sburgic/power_supply/0-35V 0-3A/doc/004.jpg

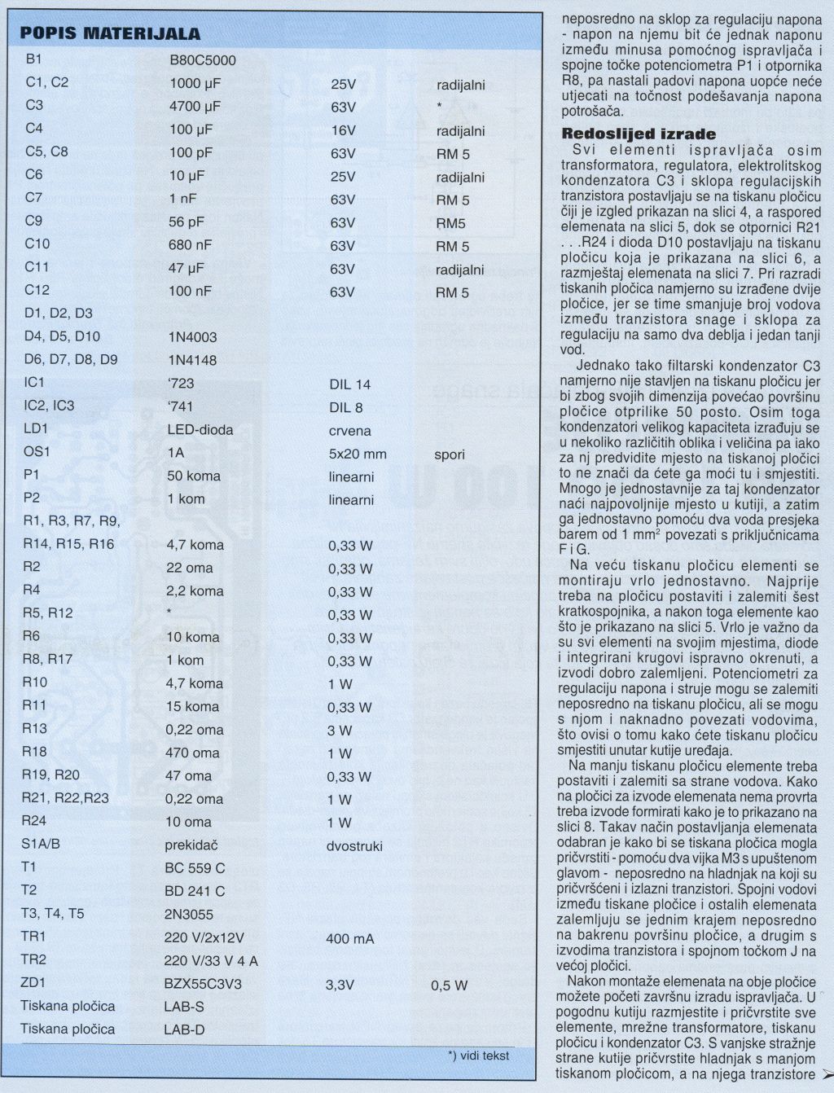
0-35V 0-3A/doc/004.jpg
