sburgic/power_supply/0-35V 0-3A/doc/001.jpg

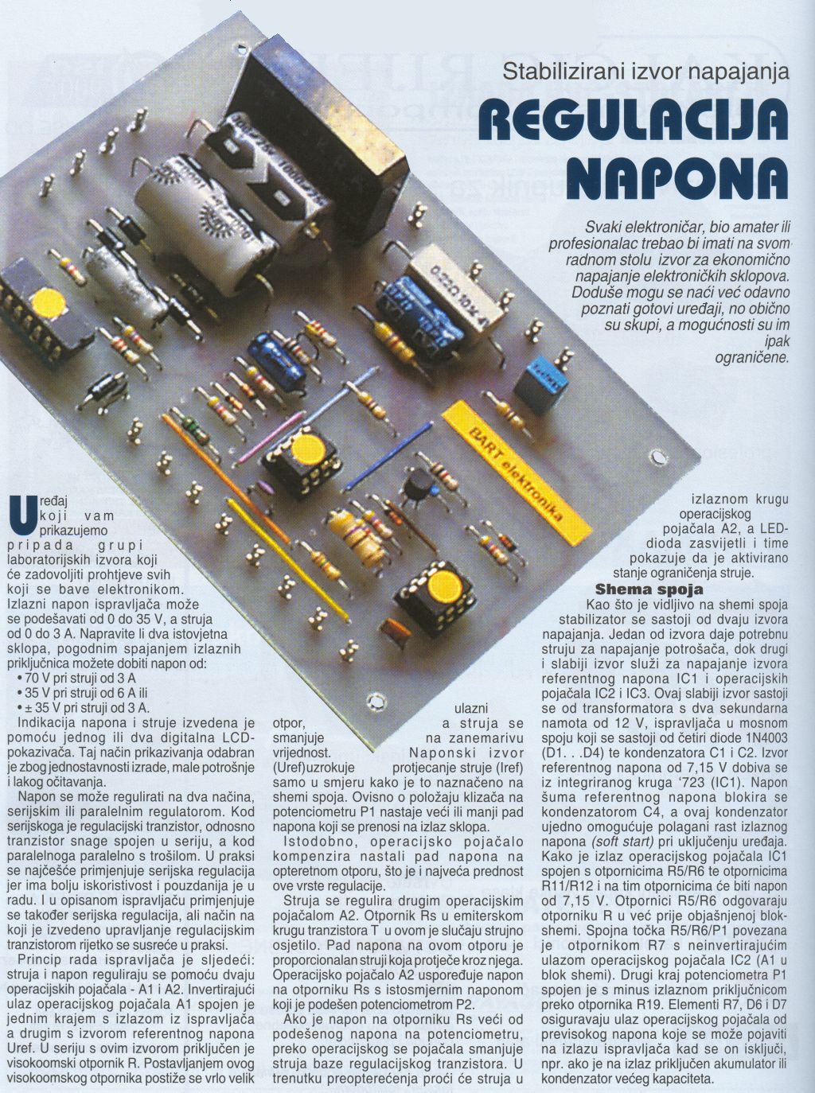
0-35V 0-3A/doc/001.jpg
