sburgic/power_supply/0-35V 0-3A/doc/005.jpg

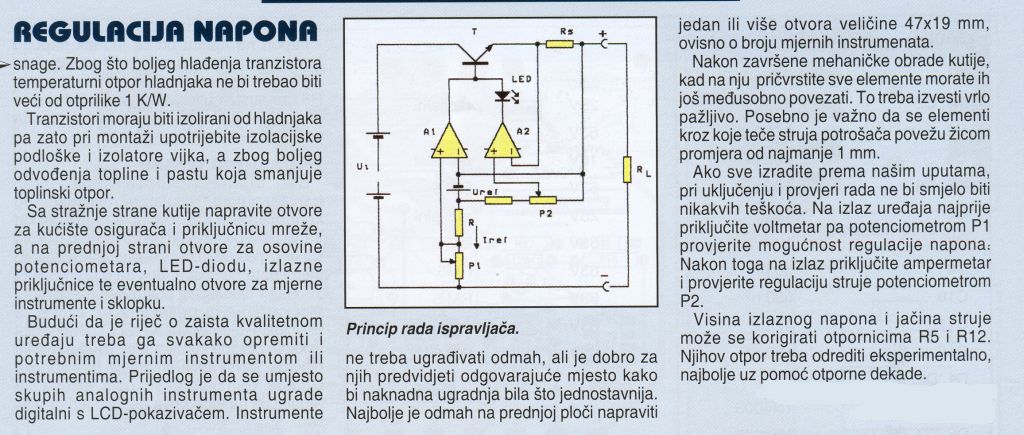
0-35V 0-3A/doc/005.jpg
