sburgic/power_supply/0-35V 0-3A/doc/old_eagle_schematics_35v_3a.pdf

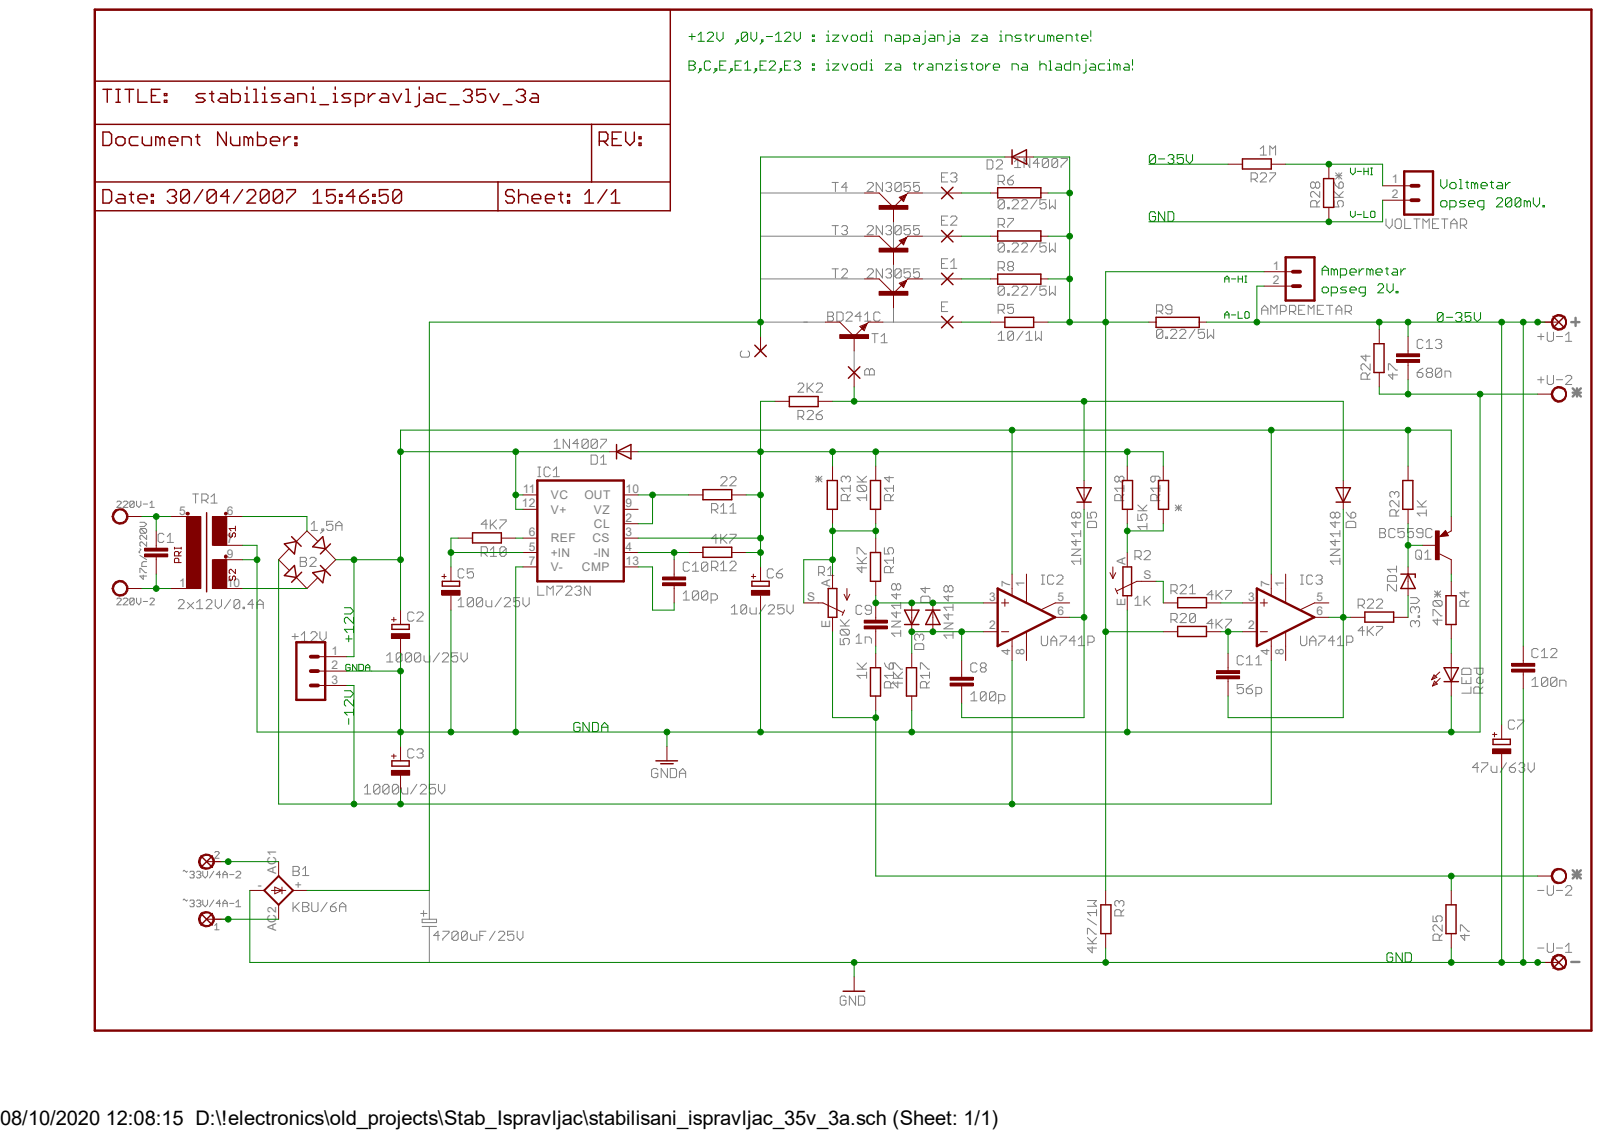
[picture p6: page 1]
OUT; REF 6 +IN 5 V- 7; CMP

08/10/2020 12:08:15 D:\!electronics\old_projects\Stab_Ispravljac\stabilisani_ispravljac_35v_3a.sch (Sheet: 1/1)
