sburgic/power_supply/0-35V 0-3A/kicad/power_supply_35V_3A.kicad_pcb

## KiCad design 0-35V 0-3A/kicad/power_supply_35V_3A.kicad_pcb (2020-10-16)

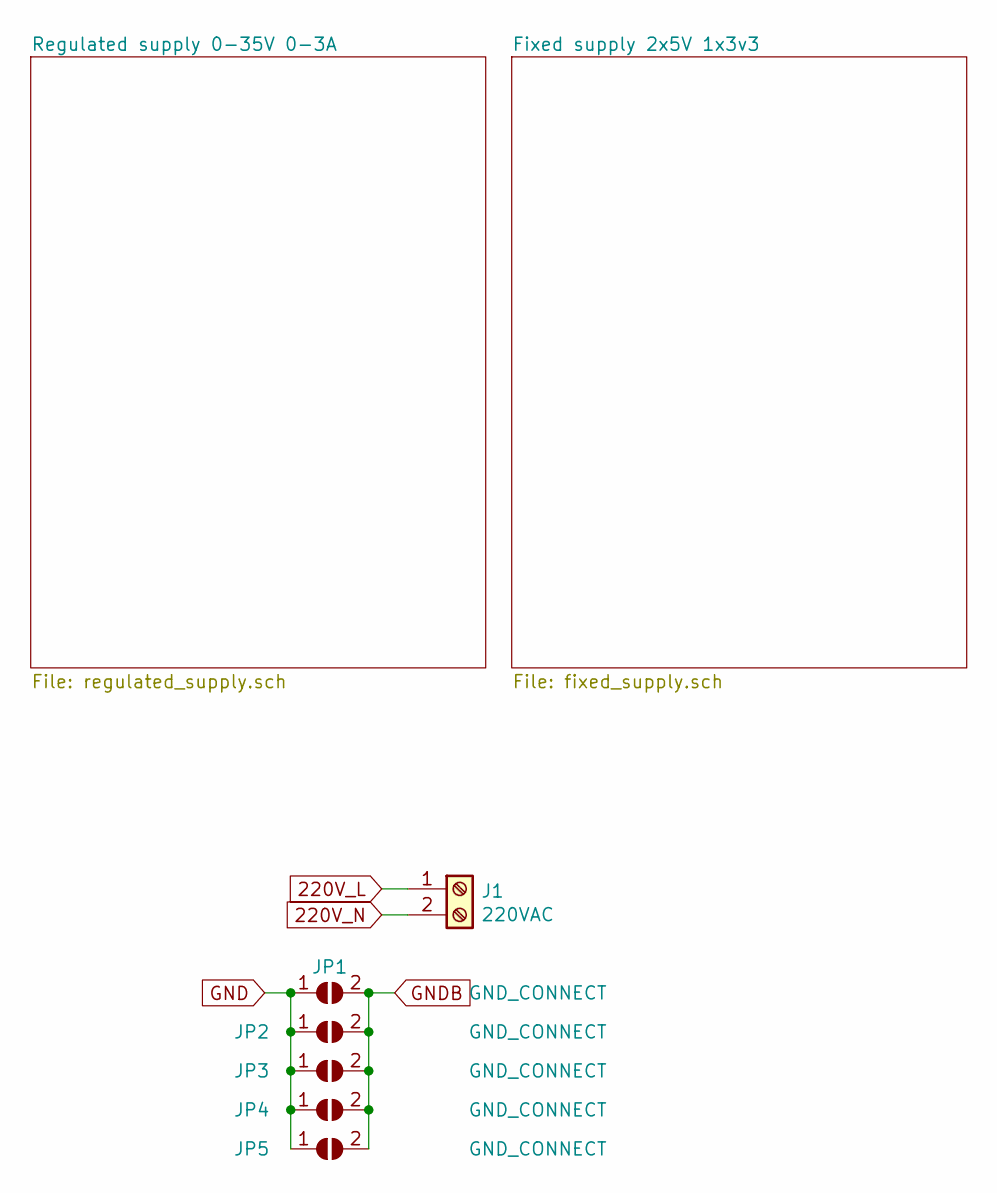
[picture p7: schematic power_supply_35V_3A.sch]

Parts:
J1: 220VAC; TerminalBlock_RND_205-00001_1x02_P5.00mm_Horizontal
JP1, JP2, JP3, JP4, JP5: GND_CONNECT; SolderJumper-2_P1.3mm_Open_Pad1.0x1.5mm

Connections:
220V_L: J1.1; also elsewhere on the board
220V_N: J1.2; also elsewhere on the board
GND: JP1.1 (A), JP2.1 (A), JP3.1 (A), JP4.1 (A), JP5.1 (A); also elsewhere on the board
GNDB: JP1.2 (B), JP2.2 (B), JP3.2 (B), JP4.2 (B), JP5.2 (B); also elsewhere on the board

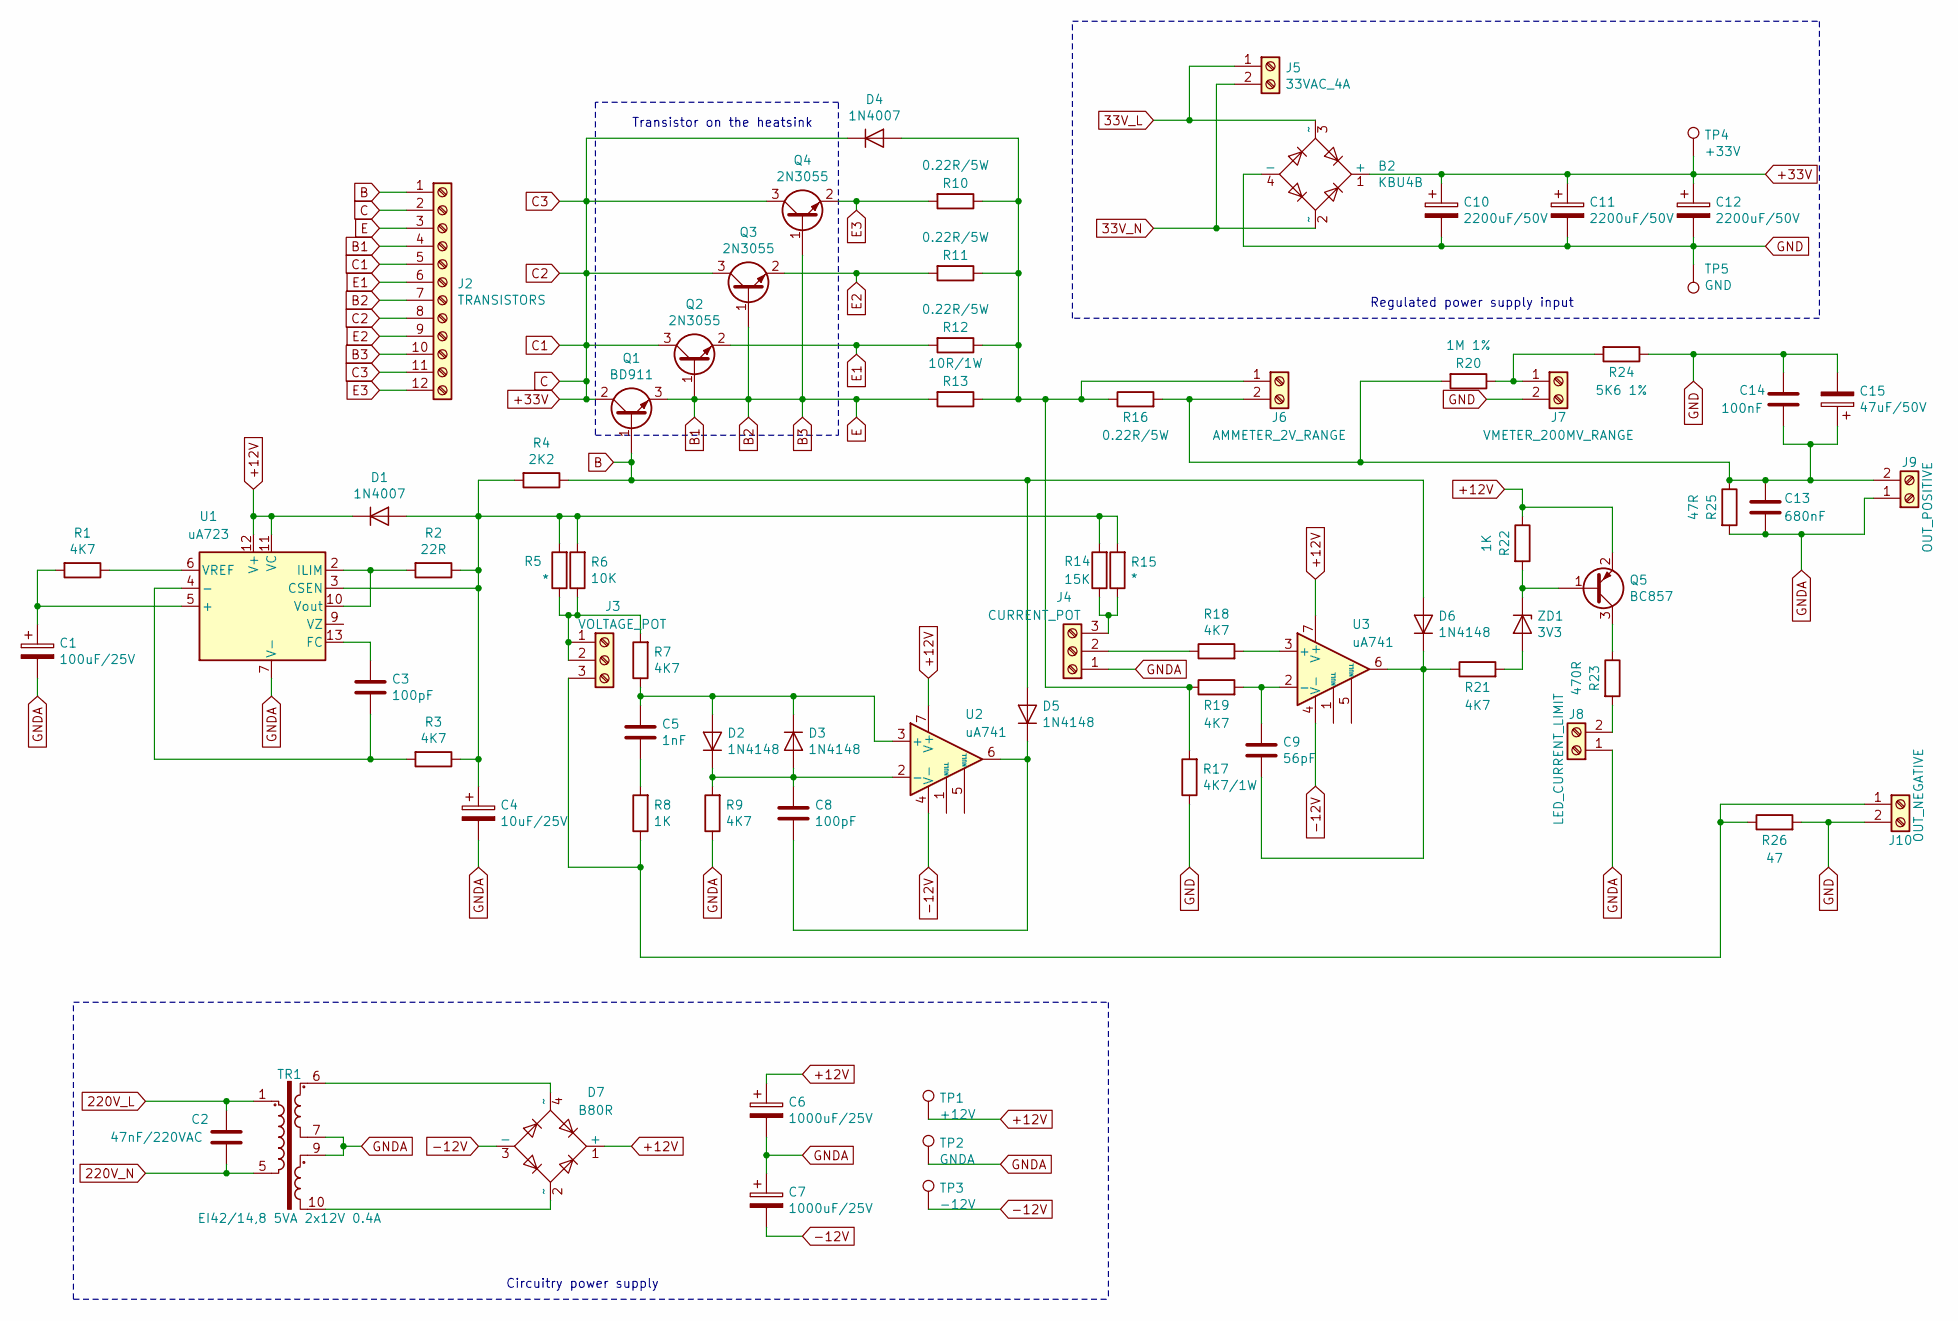
[picture p8: schematic regulated_supply.sch]

Parts:
B2: KBU4B; Diode_Bridge_Vishay_KBU
C1: 100uF/25V; CP_Radial_D6.3mm_P2.50mm
C2: 47nF/220VAC; C_Rect_L16.5mm_W7.3mm_P15.00mm_MKT
C3, C8: 100pF; C_0805_2012Metric_Pad1.15x1.40mm_HandSolder
C4: 10uF/25V; CP_Radial_D6.3mm_P2.50mm
C5: 1nF; R_0603_1608Metric_Pad1.05x0.95mm_HandSolder
C6, C7: 1000uF/25V; CP_Radial_D12.5mm_P5.00mm
C9: 56pF; C_0805_2012Metric_Pad1.15x1.40mm_HandSolder
C10, C11, C12: 2200uF/50V; CP_Radial_D16.0mm_P7.50mm
C13: 680nF; C_0805_2012Metric_Pad1.15x1.40mm_HandSolder
C14: 100nF; R_0603_1608Metric_Pad1.05x0.95mm_HandSolder
C15: 47uF/50V; CP_Radial_D6.3mm_P2.50mm
D1, D4: 1N4007; D_DO-41_SOD81_P10.16mm_Horizontal
D2, D3, D5, D6: 1N4148; D_DO-35_SOD27_P7.62mm_Horizontal
D7: B80R; Diode_Bridge_Round_D9.0mm
J2: TRANSISTORS; TerminalBlock_RND_205-00055_1x12_P5.00mm_Horizontal
J3: VOLTAGE_POT; TerminalBlock_TE_282834-3_1x03_P2.54mm_Horizontal
J4: CURRENT_POT; TerminalBlock_TE_282834-3_1x03_P2.54mm_Horizontal
J5: 33VAC_4A; TerminalBlock_bornier-2_P5.08mm
J6: AMMETER_2V_RANGE; TerminalBlock_TE_282834-2_1x02_P2.54mm_Horizontal
J7: VMETER_200MV_RANGE; TerminalBlock_TE_282834-2_1x02_P2.54mm_Horizontal
J8: LED_CURRENT_LIMIT; TerminalBlock_TE_282834-2_1x02_P2.54mm_Horizontal
J9: OUT_POSITIVE; TerminalBlock_RND_205-00001_1x02_P5.00mm_Horizontal
J10: OUT_NEGATIVE; TerminalBlock_RND_205-00001_1x02_P5.00mm_Horizontal
Q1: BD911; TO-220-3_Vertical
Q2, Q3, Q4: 2N3055; TO-3
Q5: BC857; SOT-23
R1, R3, R7, R9, R18, R19, R21: 4K7; R_0805_2012Metric_Pad1.15x1.40mm_HandSolder
R2: 22R; R_0805_2012Metric_Pad1.15x1.40mm_HandSolder
R4: 2K2; R_0805_2012Metric_Pad1.15x1.40mm_HandSolder
R5, R15: *; R_0805_2012Metric_Pad1.15x1.40mm_HandSolder
R6: 10K; R_0805_2012Metric_Pad1.15x1.40mm_HandSolder
R8, R22: 1K; R_0805_2012Metric_Pad1.15x1.40mm_HandSolder
R10, R11, R12, R16: 0.22R/5W; R_Axial_Power_L20.0mm_W6.4mm_P5.08mm_Vertical
R13: 10R/1W; R_Bare_Metal_Element_L12.4mm_W4.8mm_P11.40mm
R14: 15K; R_0805_2012Metric_Pad1.15x1.40mm_HandSolder
R17: 4K7/1W; R_Bare_Metal_Element_L12.4mm_W4.8mm_P11.40mm
R20: 1M 1%; R_0805_2012Metric_Pad1.15x1.40mm_HandSolder
R23: 470R; R_0805_2012Metric_Pad1.15x1.40mm_HandSolder
R24: 5K6 1%; R_0805_2012Metric_Pad1.15x1.40mm_HandSolder
R25: 47R; R_0805_2012Metric_Pad1.15x1.40mm_HandSolder
R26: 47; R_0805_2012Metric_Pad1.15x1.40mm_HandSolder
TP1: +12V; TestPoint_Pad_D3.0mm
TP2: GNDA; TestPoint_Pad_D3.0mm
TP3: -12V; TestPoint_Pad_D3.0mm
TP4: +33V; TestPoint_Pad_D3.0mm
TP5: GND; TestPoint_Pad_D3.0mm
TR1: EI42/14,8 5VA 2x12V 0.4A; Transformer_Breve_TEZ-38x45
U1: uA723; DIP-14_W7.62mm
U2, U3: uA741; DIP-8_W7.62mm
ZD1: 3V3; D_DO-35_SOD27_P7.62mm_Horizontal

Connections:
33V_L: B2.3 (~~), J5.1
33V_N: B2.2 (~~), J5.2
220V_L: C2.1, TR1.1; also elsewhere on the board
220V_N: C2.2, TR1.5; also elsewhere on the board
+12V: C6.1, D1.1 (K), D7.1 (+), Q5.2 (E), R22.1, TP1.1, U1.11 (VC), U1.12 (V+), U2.7 (V+), U3.7 (V+)
+33V: B2.1 (+), C10.1, C11.1, C12.1, D4.1 (K), J2.2, J2.5, J2.8, J2.11, Q1.2 (C), Q2.3 (C), Q3.3 (C), Q4.3 (C), TP4.1
-12V: C7.2, D7.3 (-), TP3.1, U2.4 (V-), U3.4 (V-)
B: D5.2 (A), D6.2 (A), J2.1, Q1.1 (B), R4.1
B1: J2.3, J2.4, J2.7, J2.10, Q1.3 (E), Q2.1 (B), Q3.1 (B), Q4.1 (B), R13.2
E1: J2.6, Q2.2 (E), R12.2
E2: J2.9, Q3.2 (E), R11.2
E3: J2.12, Q4.2 (E), R10.2
GND: B2.4 (-), C10.2, C11.2, C12.2, C14.1, C15.2, J7.2, J10.2, R17.1, R24.1, R26.2, TP5.1; also elsewhere on the board
GNDA: C1.2, C4.2, C6.2, C7.1, C13.2, J4.1, J8.1, J9.1, R9.1, R25.2, TP2.1, TR1.7, TR1.9, U1.7 (V-)
unnamed: C1.1, R1.2, U1.5 (+)
unnamed: C3.1, U1.13 (FC)
unnamed: C3.2, R3.2, U1.4 (-)
unnamed: C4.1, D1.2 (A), R2.1, R3.1, R4.2, R5.2, R6.2, R14.2, R15.2, U1.3 (CSEN)
unnamed: C5.1, D2.2 (A), D3.1 (K), R7.1, U2.3 (+)
unnamed: C5.2, R8.2
unnamed: C8.1, D2.1 (K), D3.2 (A), R9.2, U2.2 (-)
unnamed: C8.2, D5.1 (K), U2.6
unnamed: C9.1, R19.2, U3.2 (-)
unnamed: C9.2, D6.1 (K), R21.1, U3.6
unnamed: C13.1, C14.2, C15.1, J6.2, J9.2, R16.2, R20.2, R25.1
unnamed: D4.2 (A), J6.1, R10.1, R11.1, R12.1, R13.1, R16.1, R17.2, R19.1
unnamed: D7.2 (~~), TR1.10
unnamed: D7.4 (~~), TR1.6
unnamed: J3.1, J3.2, R5.1, R6.1, R7.2
unnamed: J4.2, R18.1
unnamed: J4.3, R14.1, R15.1
unnamed: J7.1, R20.1, R24.2
unnamed: J8.2, R23.2
unnamed: J3.3, J10.1, R8.1, R26.1
unnamed: Q5.1 (B), R22.2, ZD1.1 (K)
unnamed: Q5.3 (C), R23.1
unnamed: R1.1, U1.6 (VREF)
unnamed: R2.2, U1.2 (ILIM), U1.10 (Vout)
unnamed: R18.2, U3.3 (+)
unnamed: R21.2, ZD1.2 (A)

Notes on the sheet:
Regulated power supply input
Circuitry power supply
Transistor on the heatsink

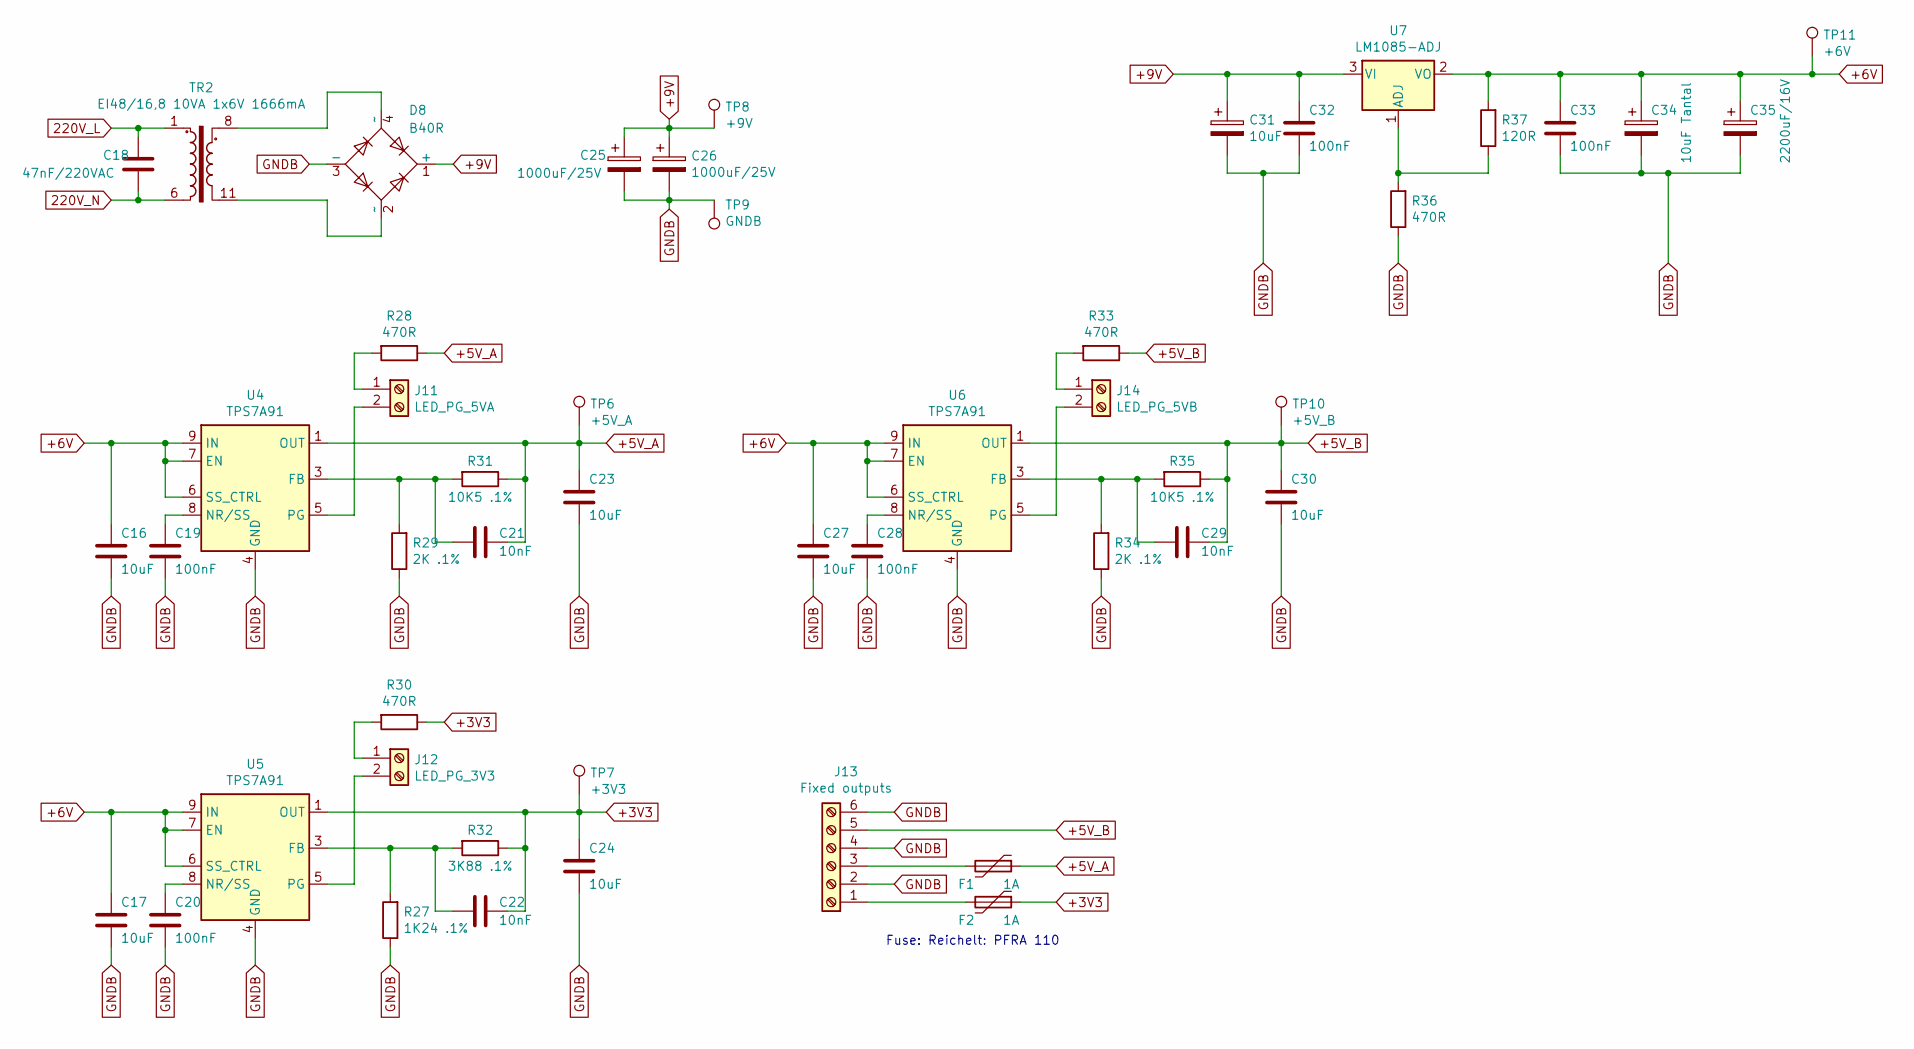
[picture p9: schematic fixed_supply.sch]

Parts:
C16, C17, C27, C30, C31: 10uF; R_0805_2012Metric
C18: 47nF/220VAC; C_Rect_L16.5mm_W7.3mm_P15.00mm_MKT
C19, C20: 100nF; R_0603_1608Metric_Pad1.05x0.95mm_HandSolder
C21, C22, C29: 10nF; R_0603_1608Metric_Pad1.05x0.95mm_HandSolder
C23: 10uF; R_0603_1608Metric_Pad1.05x0.95mm_HandSolder
C24: 10uF; R_0805_2012Metric_Pad1.15x1.40mm_HandSolder
C25, C26: 1000uF/25V; CP_Radial_D12.5mm_P5.00mm
C28, C32, C33: 100nF; R_0603_1608Metric
C34: 10uF Tantal; R_2816_7142Metric_Pad3.20x4.45mm_HandSolder
C35: 2200uF/16V; CP_Radial_D12.5mm_P5.00mm
D8: B40R; Diode_Bridge_Round_D9.0mm
F1, F2: 1A; Fuse_Littelfuse_395Series
J11: LED_PG_5VA; TerminalBlock_TE_282834-2_1x02_P2.54mm_Horizontal
J12: LED_PG_3V3; TerminalBlock_TE_282834-2_1x02_P2.54mm_Horizontal
J13: Fixed outputs; TerminalBlock_bornier-6_P5.08mm
J14: LED_PG_5VB; TerminalBlock_TE_282834-2_1x02_P2.54mm_Horizontal
R27: 1K24 .1%; R_0603_1608Metric_Pad1.05x0.95mm_HandSolder
R28, R30, R33: 470R; R_0805_2012Metric_Pad1.15x1.40mm_HandSolder
R29, R34: 2K .1%; R_0603_1608Metric_Pad1.05x0.95mm_HandSolder
R31, R35: 10K5 .1%; R_0603_1608Metric_Pad1.05x0.95mm_HandSolder
R32: 3K88 .1%; R_0603_1608Metric_Pad1.05x0.95mm_HandSolder
R36: 470R; R_0603_1608Metric_Pad1.05x0.95mm_HandSolder
R37: 120R; R_0603_1608Metric_Pad1.05x0.95mm_HandSolder
TP6: +5V_A; TestPoint_Pad_D3.0mm
TP7: +3V3; TestPoint_Pad_D3.0mm
TP8: +9V; TestPoint_Pad_D3.0mm
TP9: GNDB; TestPoint_Pad_D3.0mm
TP10: +5V_B; TestPoint_Pad_D3.0mm
TP11: +6V; TestPoint_Pad_D3.0mm
TR2: EI48/16,8 10VA 1x6V 1666mA; Transformer_Breve_TEZ-44x52
U4, U5, U6: TPS7A91; Texas_S-PDSO-N10_EP1.2x2mm
U7: LM1085-ADJ; TO-220-3_Horizontal_TabDown

Connections:
220V_L: C18.1, TR2.1; also elsewhere on the board
220V_N: C18.2, TR2.6; also elsewhere on the board
+3V3: C22.1, C24.1, F2.1, R30.1, R32.1, TP7.1, U5.1 (OUT), U5.2 (OUT)
+5V_A: C21.1, C23.1, F1.1, R28.1, R31.1, TP6.1, U4.1 (OUT), U4.2 (OUT)
+5V_B: C29.1, C30.1, J13.5, R33.1, R35.1, TP10.1, U6.1 (OUT), U6.2 (OUT)
+6V: C16.1, C17.1, C27.1, C33.1, C34.1, C35.1, R37.2, TP11.1, U4.6 (SS_CTRL), U4.7 (EN), U4.9 (IN), U4.10 (IN), U5.6 (SS_CTRL), U5.7 (EN), U5.9 (IN), U5.10 (IN), U6.6 (SS_CTRL), U6.7 (EN), U6.9 (IN), U6.10 (IN), U7.2 (VO)
+9V: C25.1, C26.1, C31.1, C32.1, D8.1 (+), TP8.1, U7.3 (VI)
GNDB: C16.2, C17.2, C19.2, C20.2, C23.2, C24.2, C25.2, C26.2, C27.2, C28.2, C30.2, C31.2, C32.2, C33.2, C34.2, C35.2, D8.3 (-), J13.2, J13.4, J13.6, R27.1, R29.1, R34.1, R36.1, TP9.1, U4.4 (GND), U4.11 (GND), U5.4 (GND), U5.11 (GND), U6.4 (GND), U6.11 (GND); also elsewhere on the board
unnamed: C19.1, U4.8 (NR/SS)
unnamed: C20.1, U5.8 (NR/SS)
unnamed: C21.2, R29.2, R31.2, U4.3 (FB)
unnamed: C22.2, R27.2, R32.2, U5.3 (FB)
unnamed: C28.1, U6.8 (NR/SS)
unnamed: C29.2, R34.2, R35.2, U6.3 (FB)
unnamed: D8.2 (~~), TR2.11
unnamed: D8.4 (~~), TR2.8
unnamed: F1.2, J13.3
unnamed: F2.2, J13.1
unnamed: J11.1, R28.2
unnamed: J11.2, U4.5 (PG)
unnamed: J12.1, R30.2
unnamed: J12.2, U5.5 (PG)
unnamed: J14.1, R33.2
unnamed: J14.2, U6.5 (PG)
unnamed: R36.2, R37.1, U7.1 (ADJ)

Notes on the sheet:
Fuse: Reichelt: PFRA 110

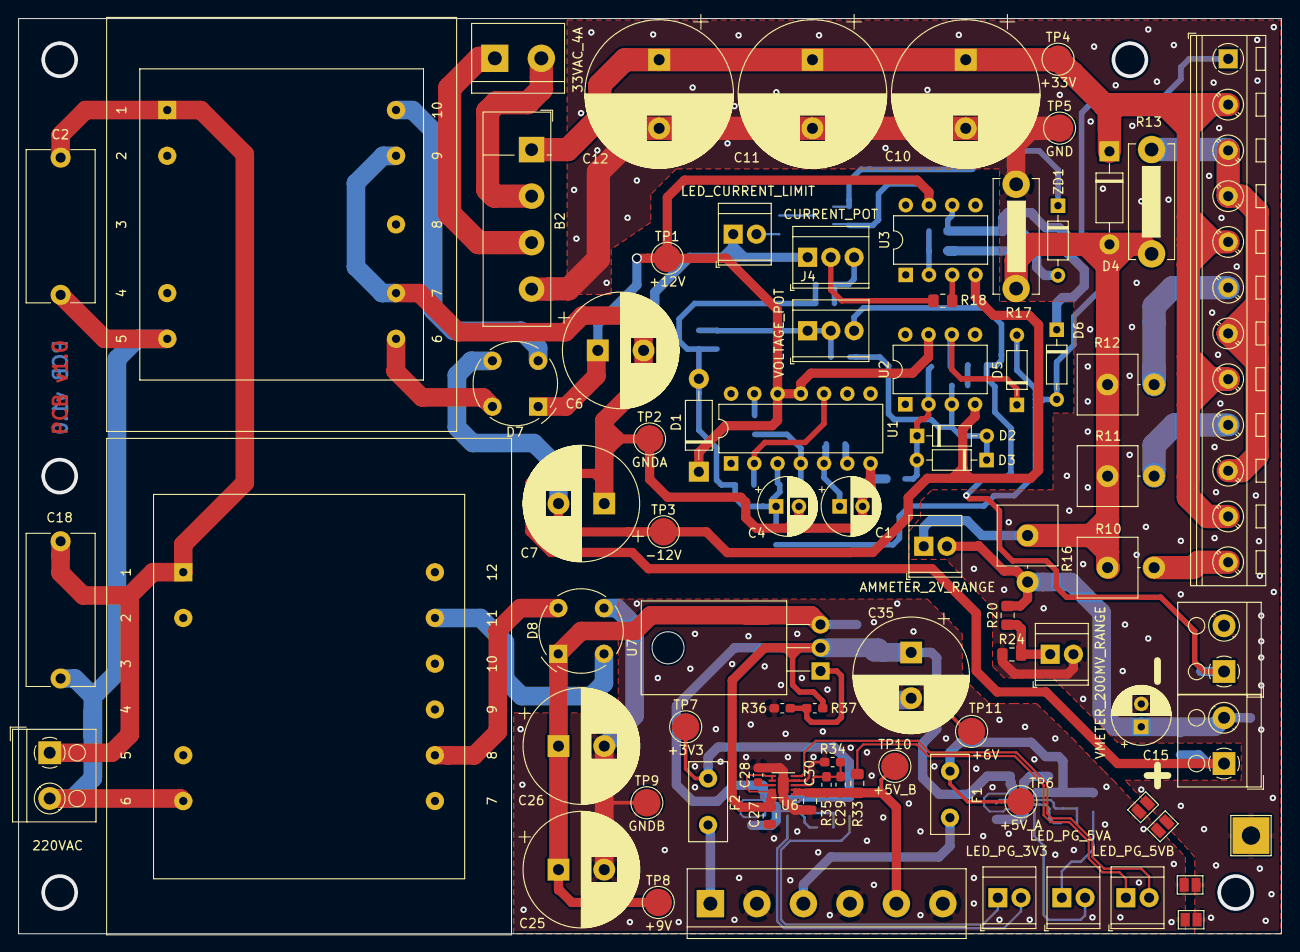
[picture p10: board power_supply_35V_3A.kicad_pcb from above]

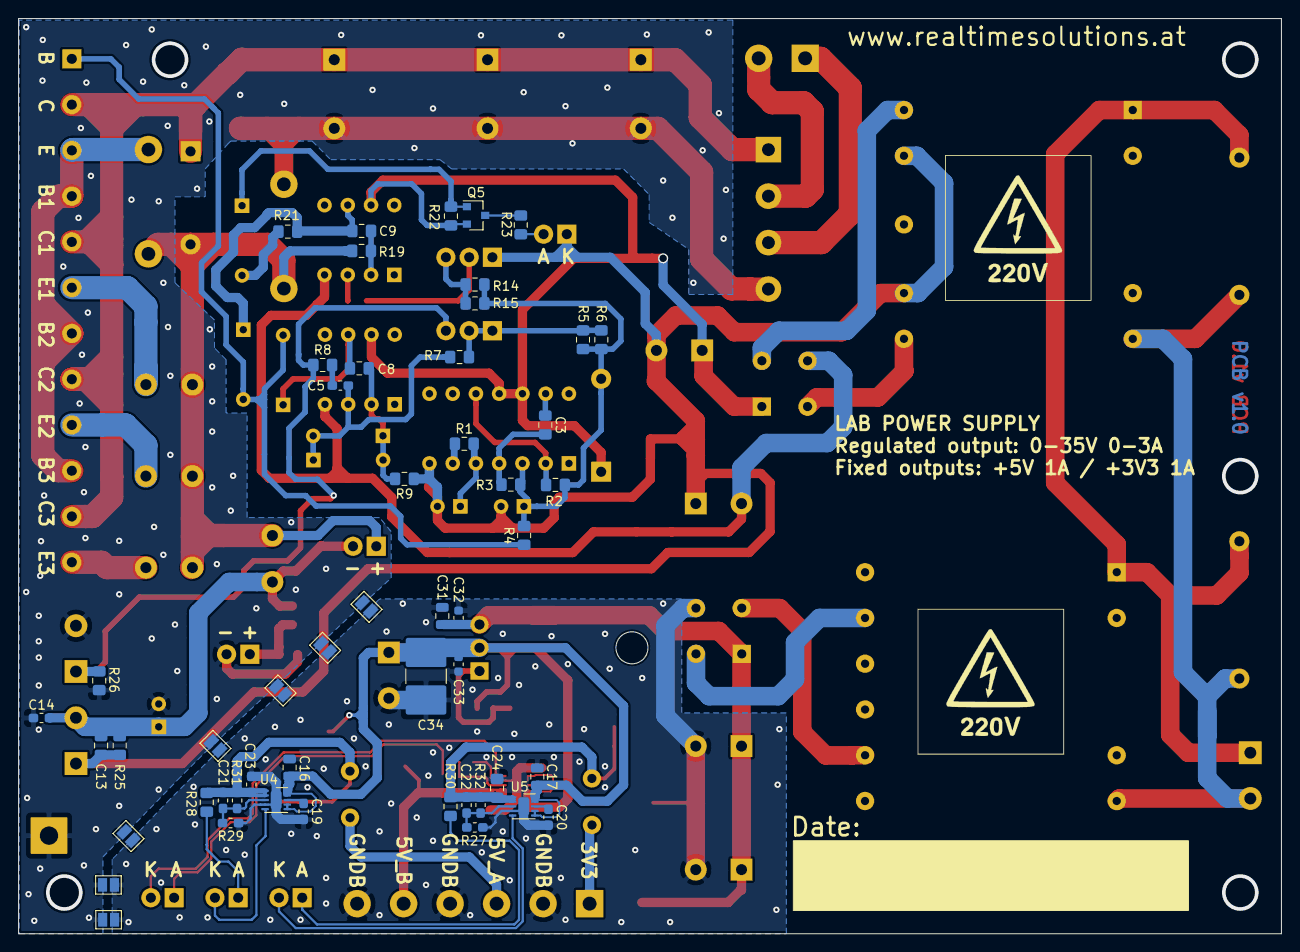
[picture p11: board power_supply_35V_3A.kicad_pcb from below]

Board: 2 copper layers, 138.0 x 100.0 mm, 130 parts (51 on the bottom side), 63 nets.

Other parts of the board:
JP2#2, JP2#3, JP4#2, JP4#3, JP4#4, JP6, JP7: GND_CONNECT; SolderJumper-2_P1.3mm_Open_Pad1.0x1.5mm
JPe: GND_CONNECT; SolderJumper-2_P1.3mm_Open_Pad1.0x1.5mm

Their connections:
GND: JP2#2.1, JP2#3.1, JP4#2.1, JP4#3.1, JP4#4.1, JP6.1, JP7.1, JPe.1; also elsewhere on the board
GNDB: JP2#2.2, JP2#3.2, JP4#2.2, JP4#3.2, JP4#4.2, JP6.2, JP7.2, JPe.2; also elsewhere on the board
