sburgic/power_supply/(commit log)

2020-10-14 add pcb ver 1.0
    [fixed_supply.sch, power_supply_35V_3A.kicad_pcb, power_supply_35V_3A.sch, regulated_supply.sch]
2020-10-16 fix PCB ground planes
    [power_supply_35V_3A.kicad_pcb, power_supply_35V_3A.sch, regulated_supply.sch]
